bagualracing/TAURA-controladora/controladora_v1.1.3/Guia de Testes Controladora v1.1.3 - Imagens/fontes.JPG

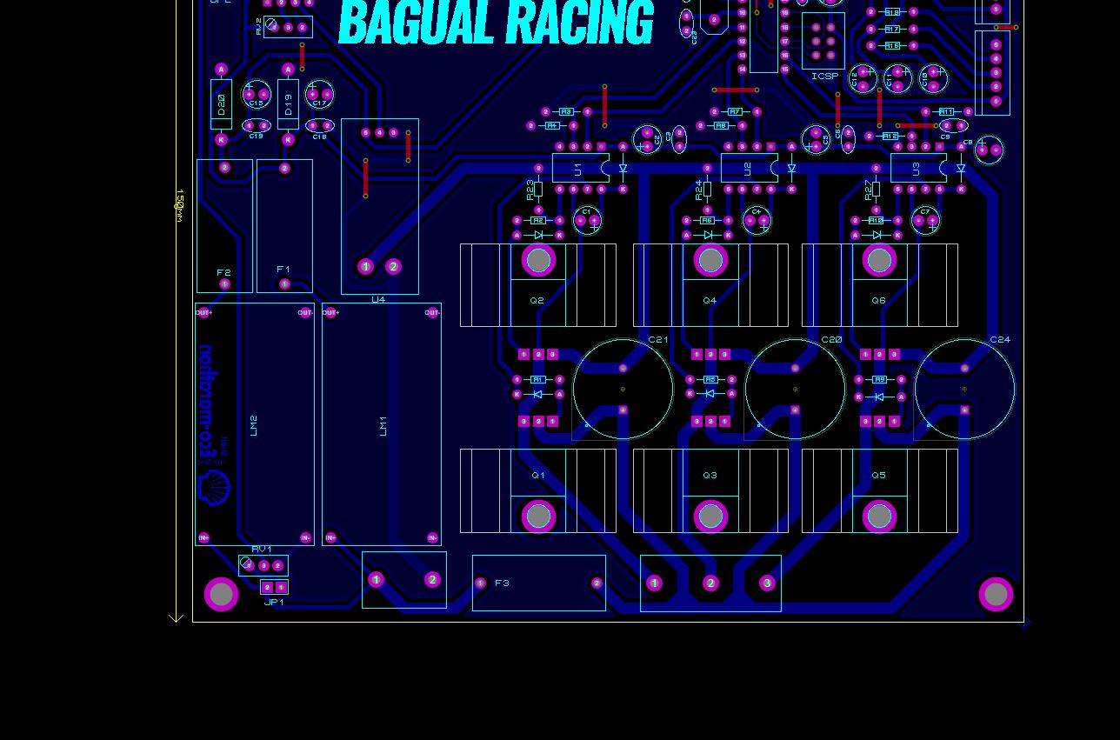
controladora_v1.1.3/Guia de Testes Controladora v1.1.3 - Imagens/fontes.JPG
