bagualracing/TAURA-controladora/controladora_v1.1.3/Guia de Testes Controladora v1.1.3 - Imagens/sensor_v.jpg

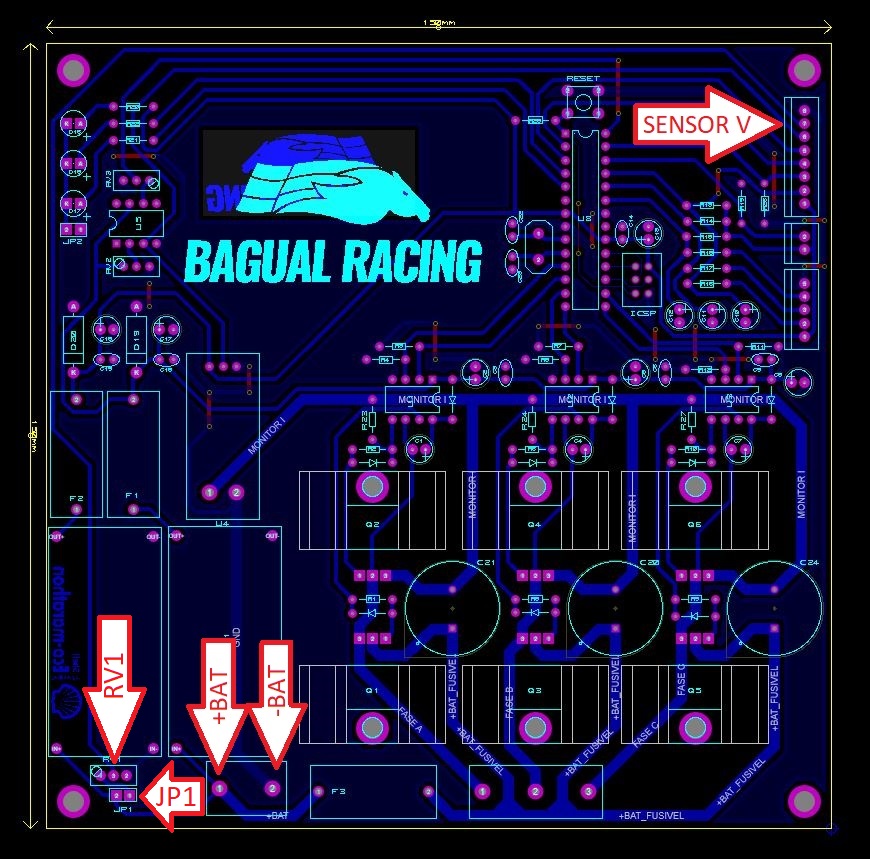
controladora_v1.1.3/Guia de Testes Controladora v1.1.3 - Imagens/sensor_v.jpg
