bagualracing/TAURA-controladora/README.md

# TAURA-controladora
Repositório para códigos da controladora. <br />
Neste repositório deve-se colocar arquivos de programas relacionados à controladora como:
- Arquivos em Arduino (em suas respectivas pastas)
- Arquivos .c,.h, .pdsprj (Proteus)...
- Arquivos de programas como ATMEL Studio
