bagualracing/TAURA-controladora/controladora_v1.1.3/Guia de Testes Controladora v1.1.3 - Imagens/1.JPG

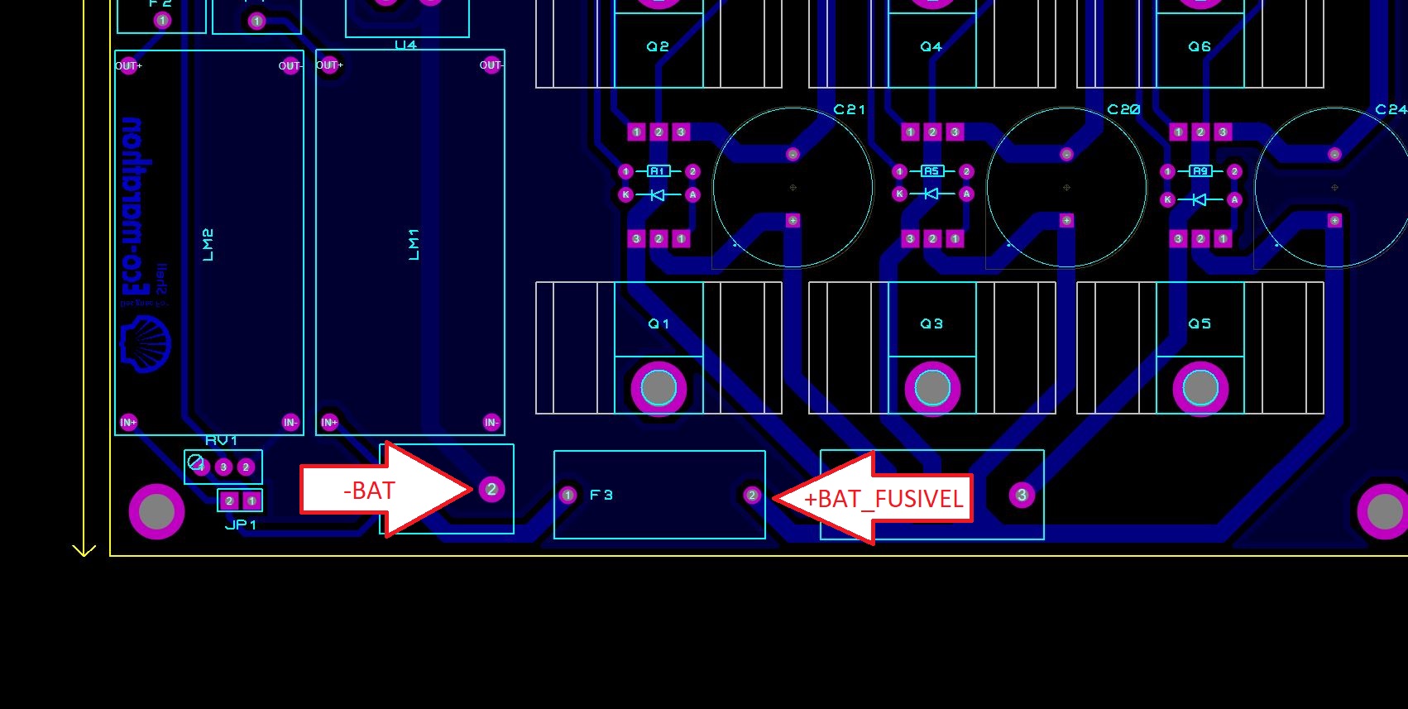
controladora_v1.1.3/Guia de Testes Controladora v1.1.3 - Imagens/1.JPG
