bagualracing/TAURA-controladora/controladora_v1.1.3/Guia de Testes Controladora v1.1.3 - Imagens/controla.jpg

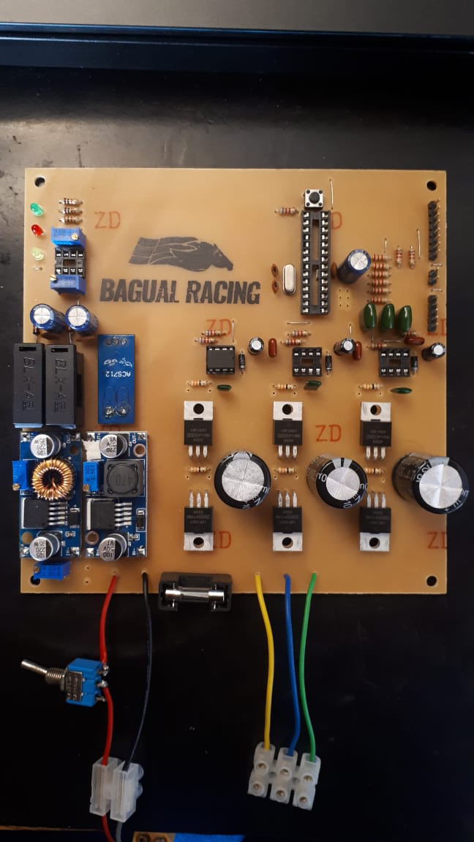
controladora_v1.1.3/Guia de Testes Controladora v1.1.3 - Imagens/controla.jpg
