bagualracing/TAURA-controladora/controladora_v1.1.3/Guia de Testes Controladora v1.1.3 - Imagens/fonte_15v.jpg

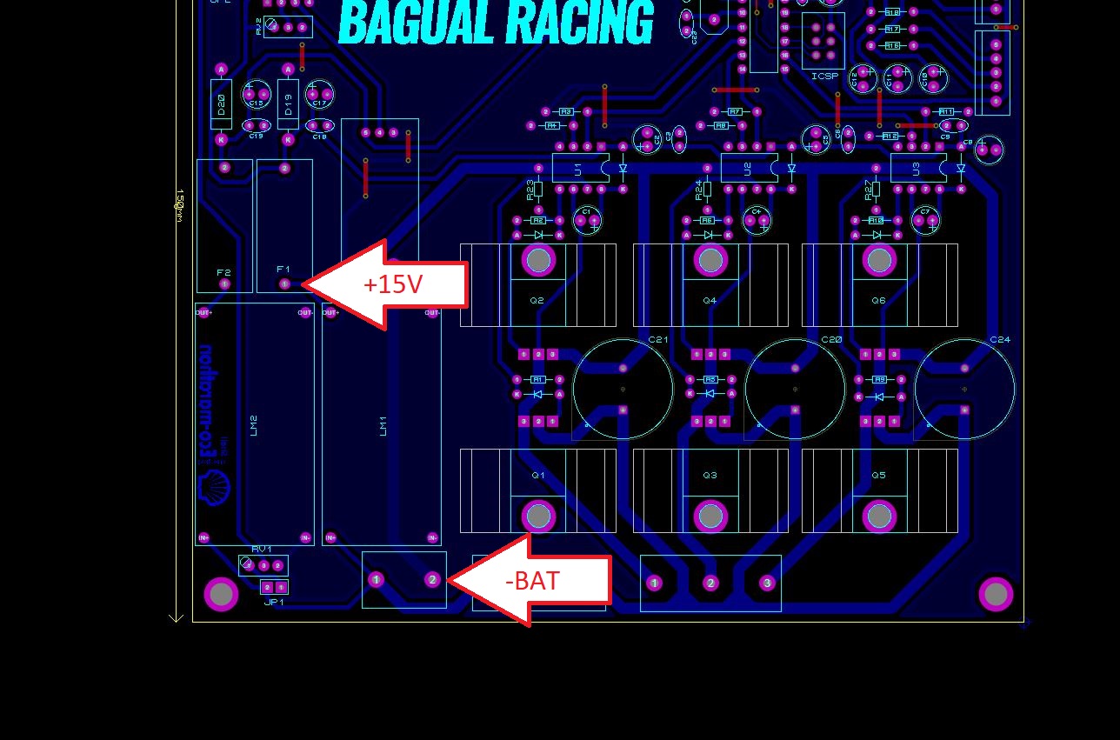
controladora_v1.1.3/Guia de Testes Controladora v1.1.3 - Imagens/fonte_15v.jpg
