bagualracing/TAURA-controladora/controladora_v1.1.3/controladora_v1.1.3_bottom_copper.pdf

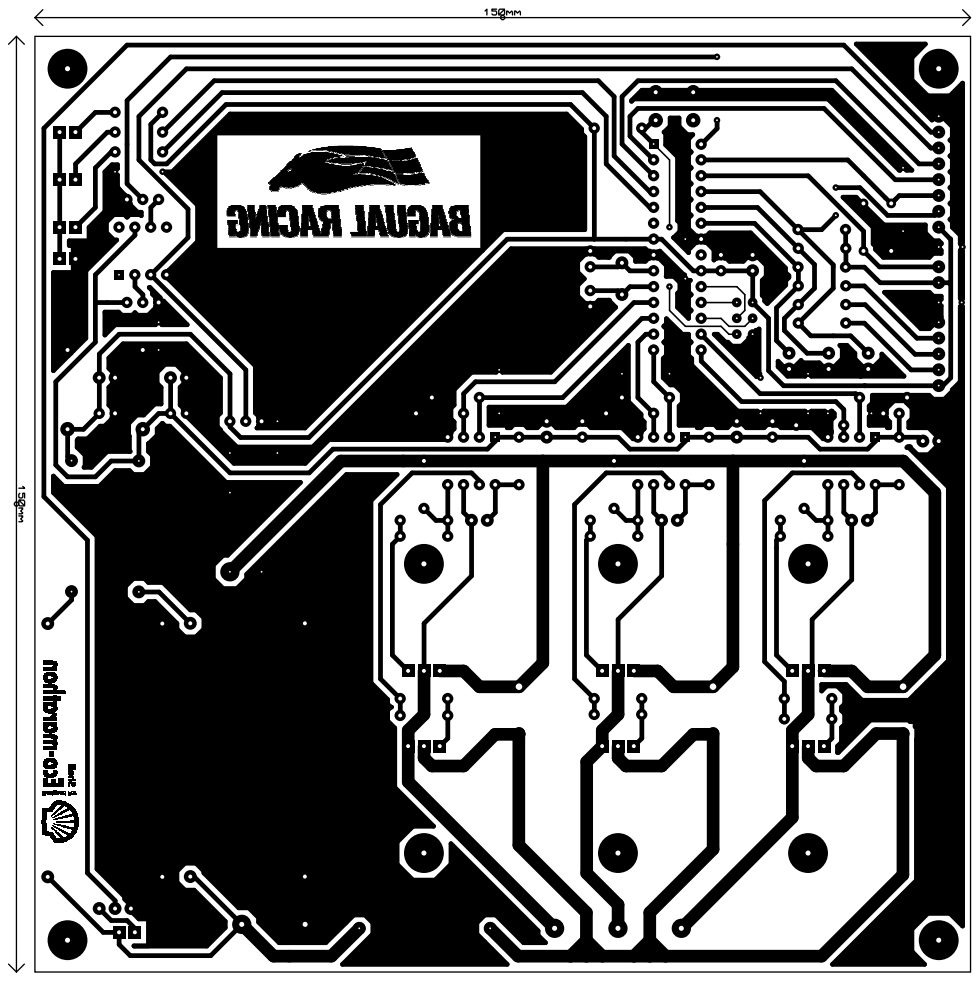
[picture p52: page 1]
