bagualracing/TAURA-controladora/controladora_v1.1.3/controladora_v1.1.3_esquematico.pdf

JP1

LM1

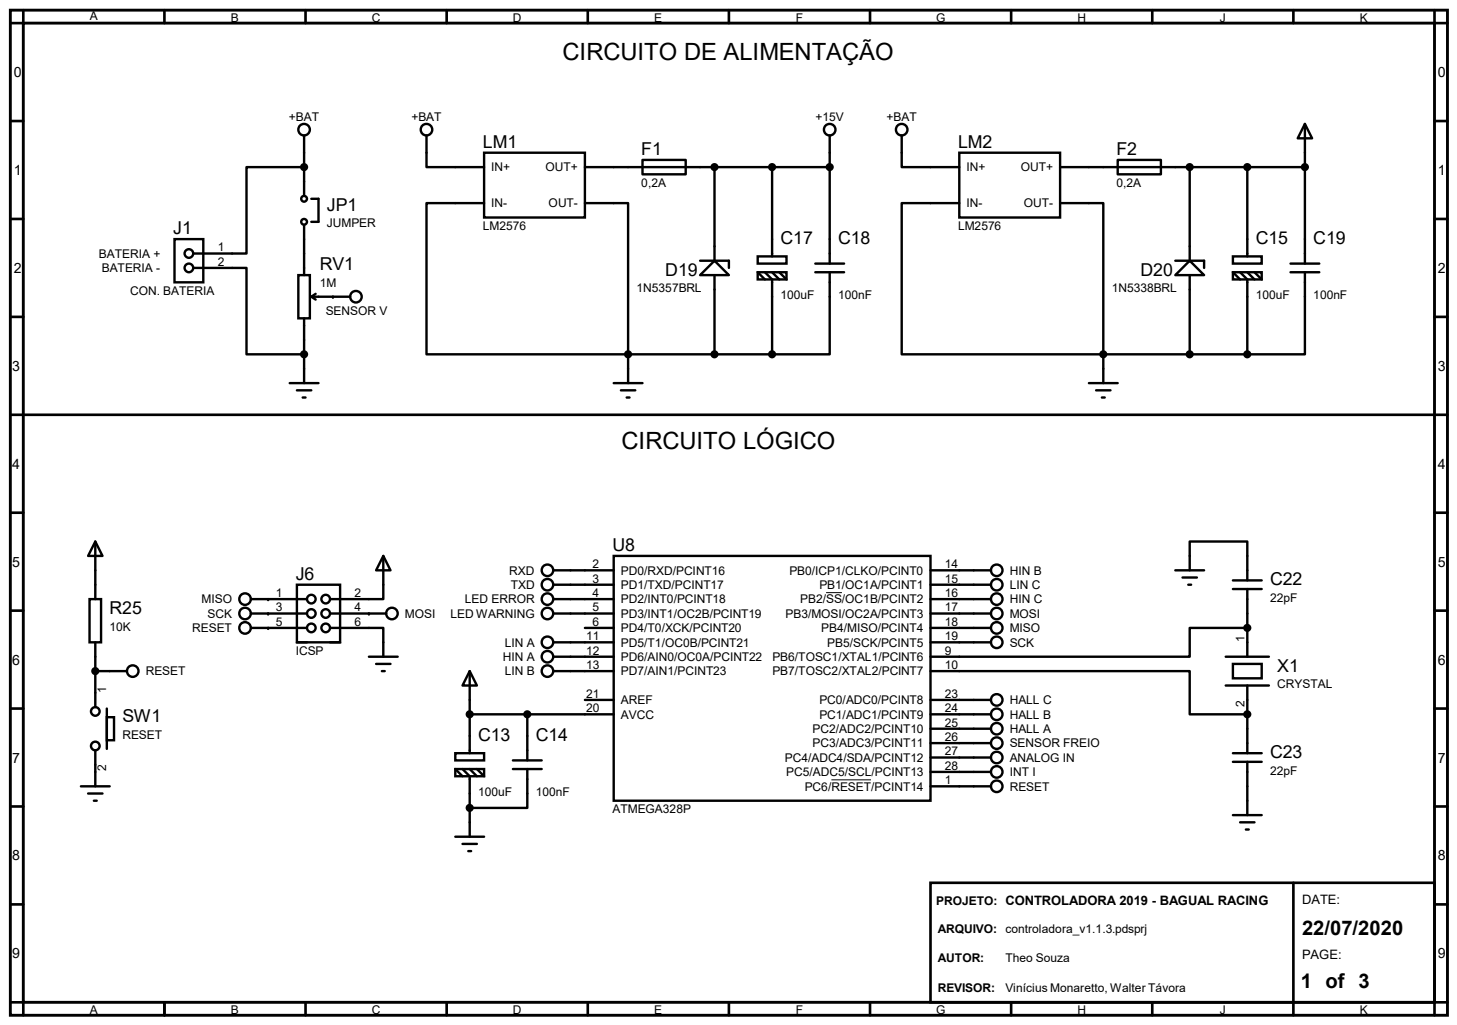
[picture p53: page 1]

PROJETO: CONTROLADORA 2019 - BAGUAL RACING

J3

R13

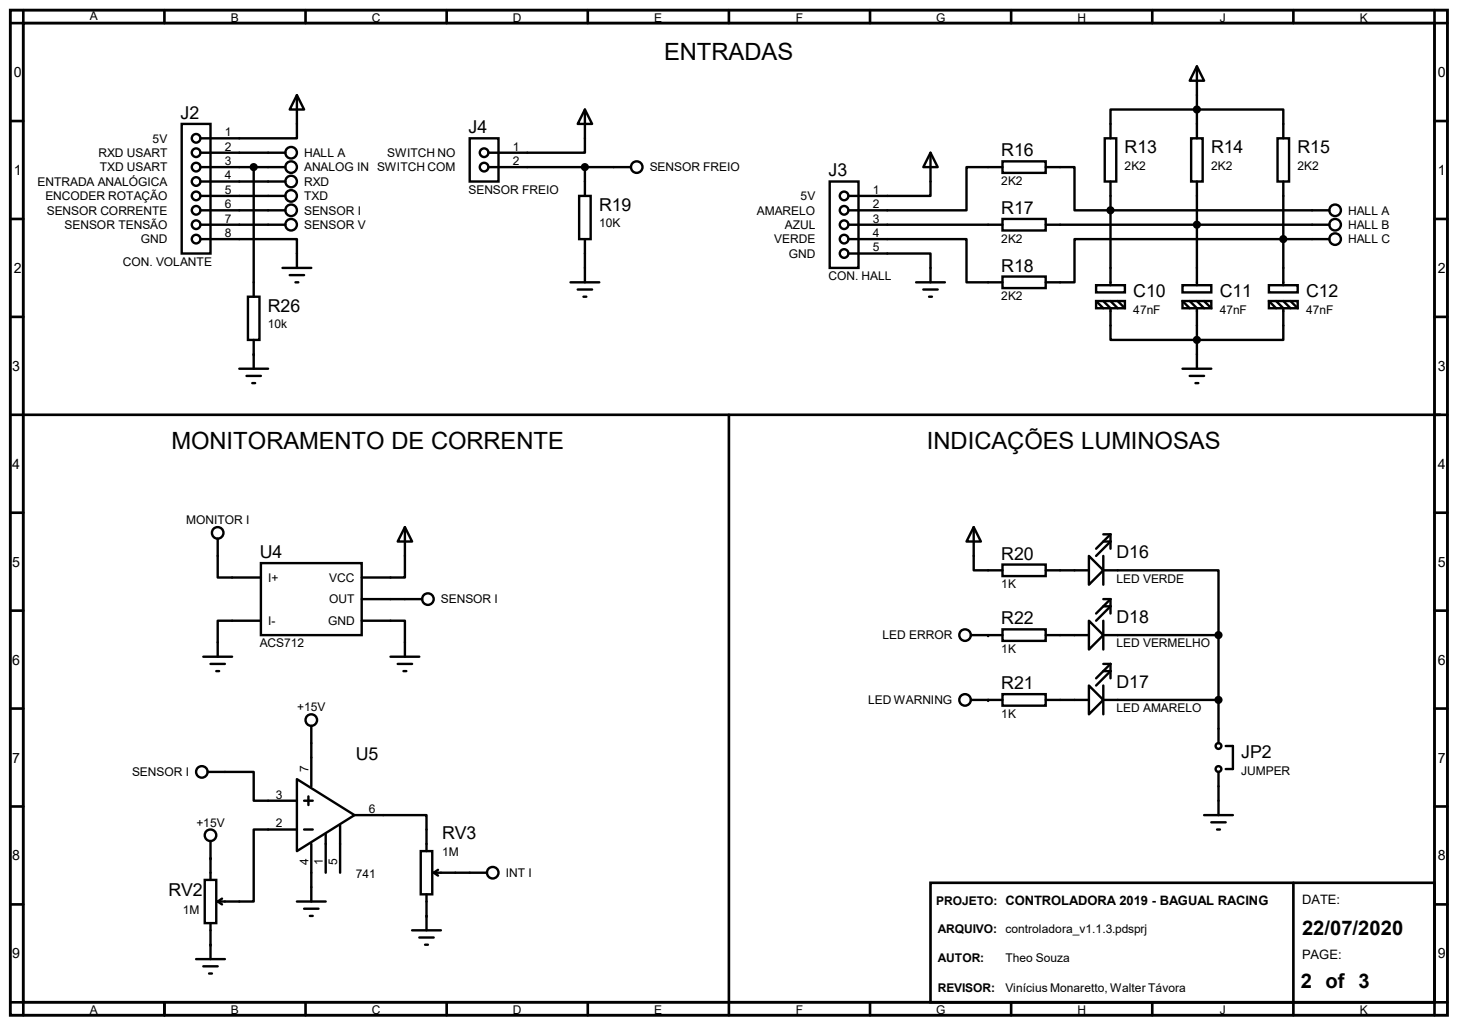
[picture p54: page 2]

PROJETO: CONTROLADORA 2019 - BAGUAL RACING

Q1
C2

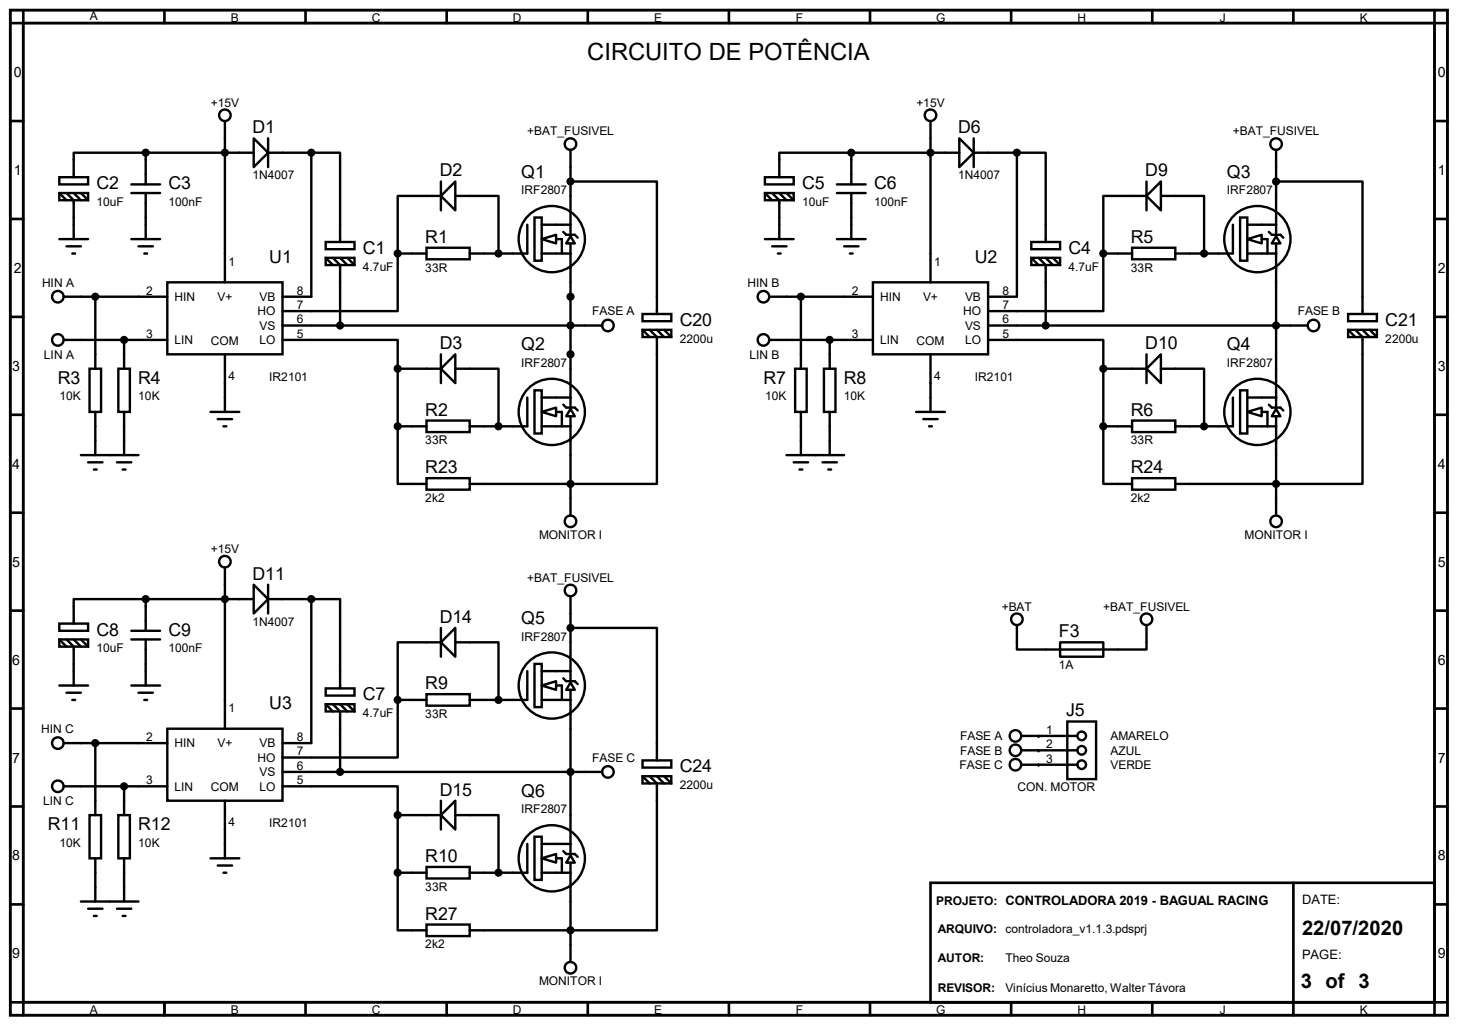
[picture p55: page 3]

PROJETO: CONTROLADORA 2019 - BAGUAL RACING
