bagualracing/TAURA-controladora/controladora_v1.1.3/controladora_v1.1.3_top_silk_invertido.pdf

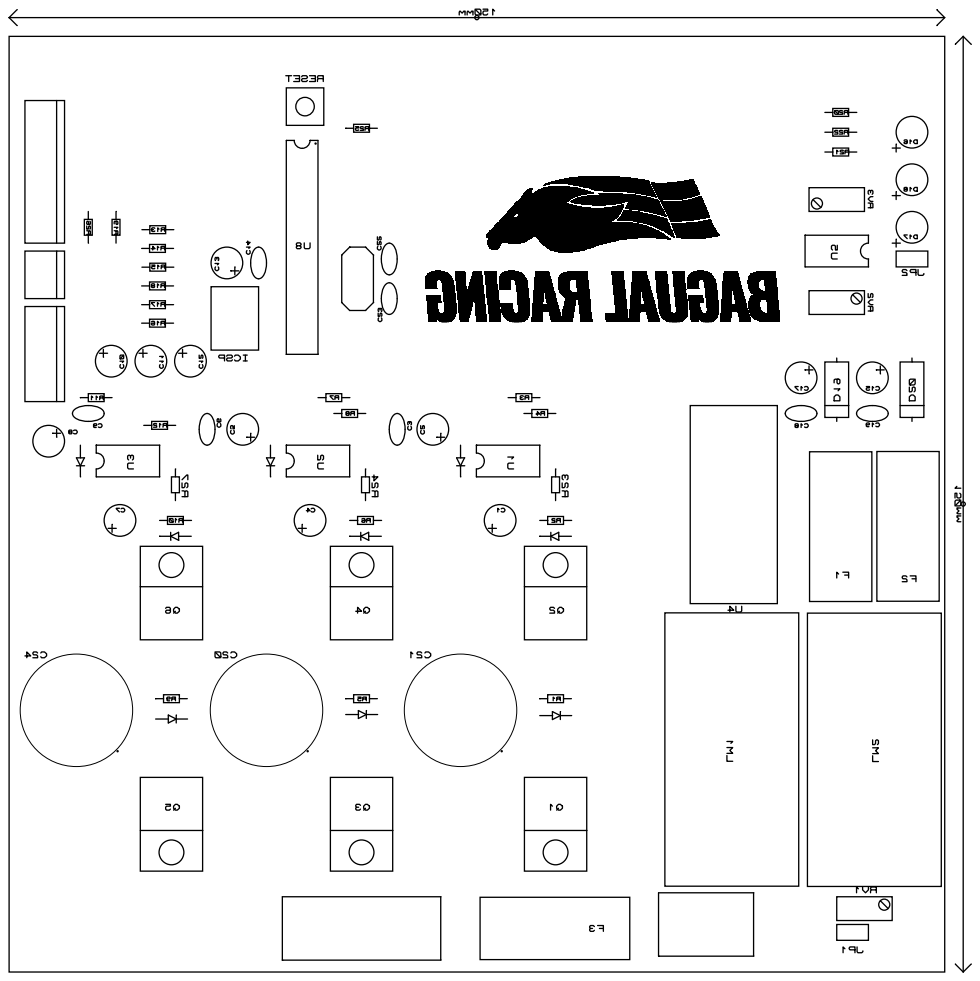
[picture p56: page 1]
