bagualracing/TAURA-controladora/(list of files, drawings)

Other design files:
controladora_v1.1.3/controladora_v1.1.3.pdsprj
ControladorBagualProgram/TesteProgramaControladoraV1.0.pdsprj
