bagualracing/TAURA-controladora/(commit log)

2021-05-01 Add files via upload
    First upload
    [TesteProgramaControladoraV1.0.pdsprj]
2021-05-01 Upload controladora_v1.1.3
    Manual de como testar a controladora, relatório de como funciona o programa da controladora, relatório sobre a parte elétrica do motor e controladora.
    [Taura - Requisitos Controladora Nova.xlsx, controladora_v1.1.3.pdsprj]
2021-09-05 Update main.c
    Correção das fases e correção de comentários.
